alibeknakhimov/Smart-Laundry-Payment-Module/hardware/PCB.png

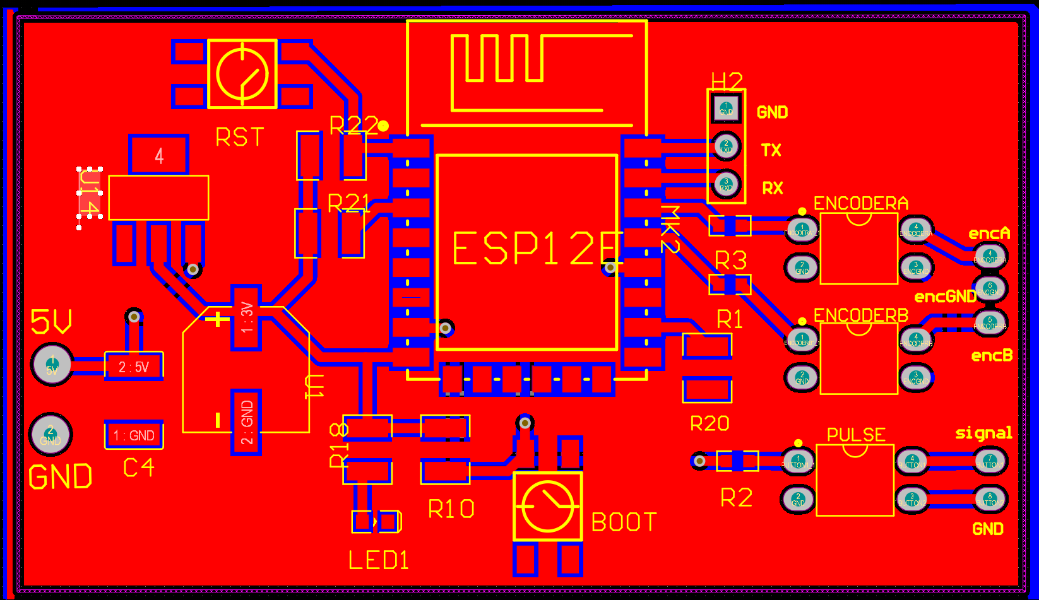
hardware/PCB.png
