alibeknakhimov/Smart-Laundry-Payment-Module/media/photos/mounting.jpg

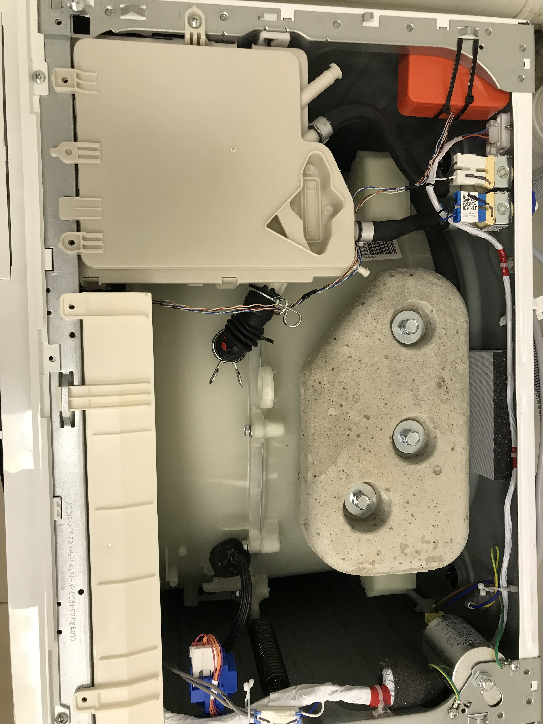
media/photos/mounting.jpg
