alibeknakhimov/Smart-Laundry-Payment-Module/media/photos/process.jpg

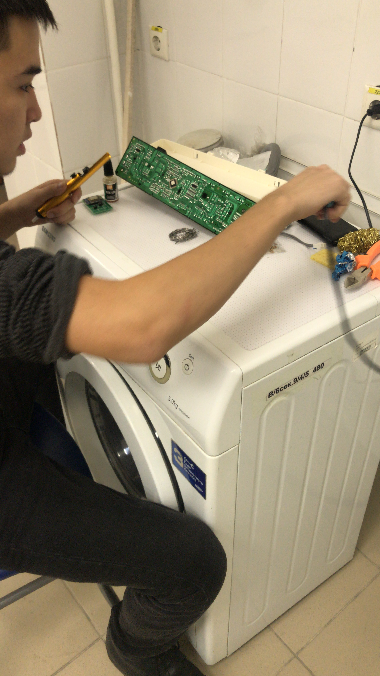
media/photos/process.jpg
