alibeknakhimov/Smart-Laundry-Payment-Module/hardware/BOM.csv

ID | Name | Designator | Footprint | Quantity | Manufacturer Part | Manufacturer | Supplier | Supplier Part | Price
1 | 560uF | U1 | CAP-SMD_BD8.0-L8.3-W8.3-LS8.9-FD | 1 | HV1C567M0810PZ | HONOR(荣誉) | LCSC | C5246532 | 0.247
2 | PC817B | PULSE,ENCODERB,ENCODERA | DIP-4_L4.6-W6.5-P2.54-LS7.6-BL | 3 | PC817B | 华润华晶 | LCSC | C115499 | 0.053
3 | TS4548TP | BOOT,RST | KEY-SMD_4P-L4.5-W4.5-P3.00-LS7.0 | 2 | TS4548TP | SHOU HAN(首韩) | LCSC | C2681489 | 0.02
4 | 10uF | C4 | C1812 | 1 | C4532X7R1H106K | TDK | LCSC | C18733 | 0.477
5 | HDR-F-2.54_1x3 | H2 | HDR-F-2.54_1X3 | 1 |  |  | LCSC | C146690 | 0.086
6 | LED-0603_B | LED1 | LED0603_BLUE | 1 | 19-217/BHC-ZL1M2RY/3T | EVERLIGHT(台湾亿光) | LCSC | C72041 | 0.023
7 | ESP-12E | MK2 | WIFIM-SMD_ESP-12E-BR | 1 | ESP-12E | Ai-Thinker | LCSC | C89297 | 2.908
8 | 10K | R10,R20,R21,R22 | R1210 | 4 | RK73B2ETTD103J | KOA | LCSC | C131365 | 0.04
9 | 330 | R18 | R1210 | 1 | RC1210JR-071KL | YAGEO | LCSC | C114690 | 0.011
10 | AMS1117-3.3 | U14 | SOT-223-3_L6.5-W3.4-P2.30-LS7.0-BR | 1 | AMS1117-3.3 | AMS | LCSC | C6186 | 0.182
11 | 220 | R1,R2,R3 | R0603 | 3
