alibeknakhimov/Smart-Laundry-Payment-Module/hardware/Schematic.pdf

# PC817B ¹²³

# 10uF GND/ADJ 1 Vout 2 Vin 3 Vout 4

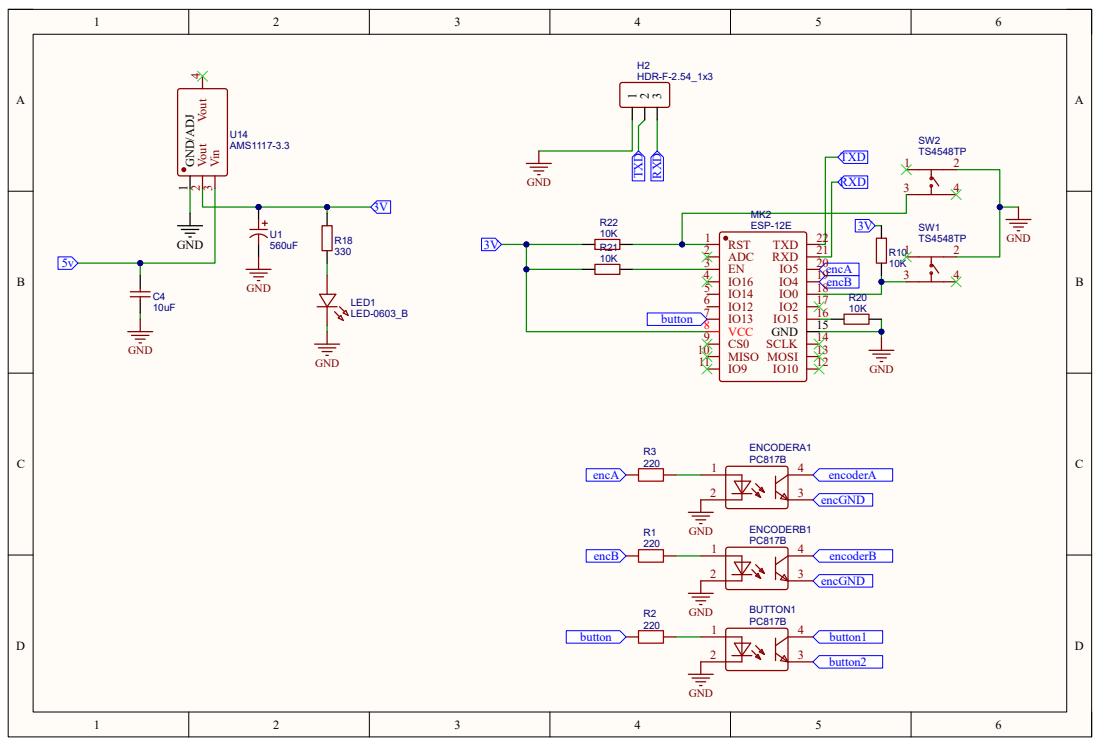
[picture p5: page 1]
